gutierrezps/da-pimp-plus/da-pimp-plus-sch.pdf

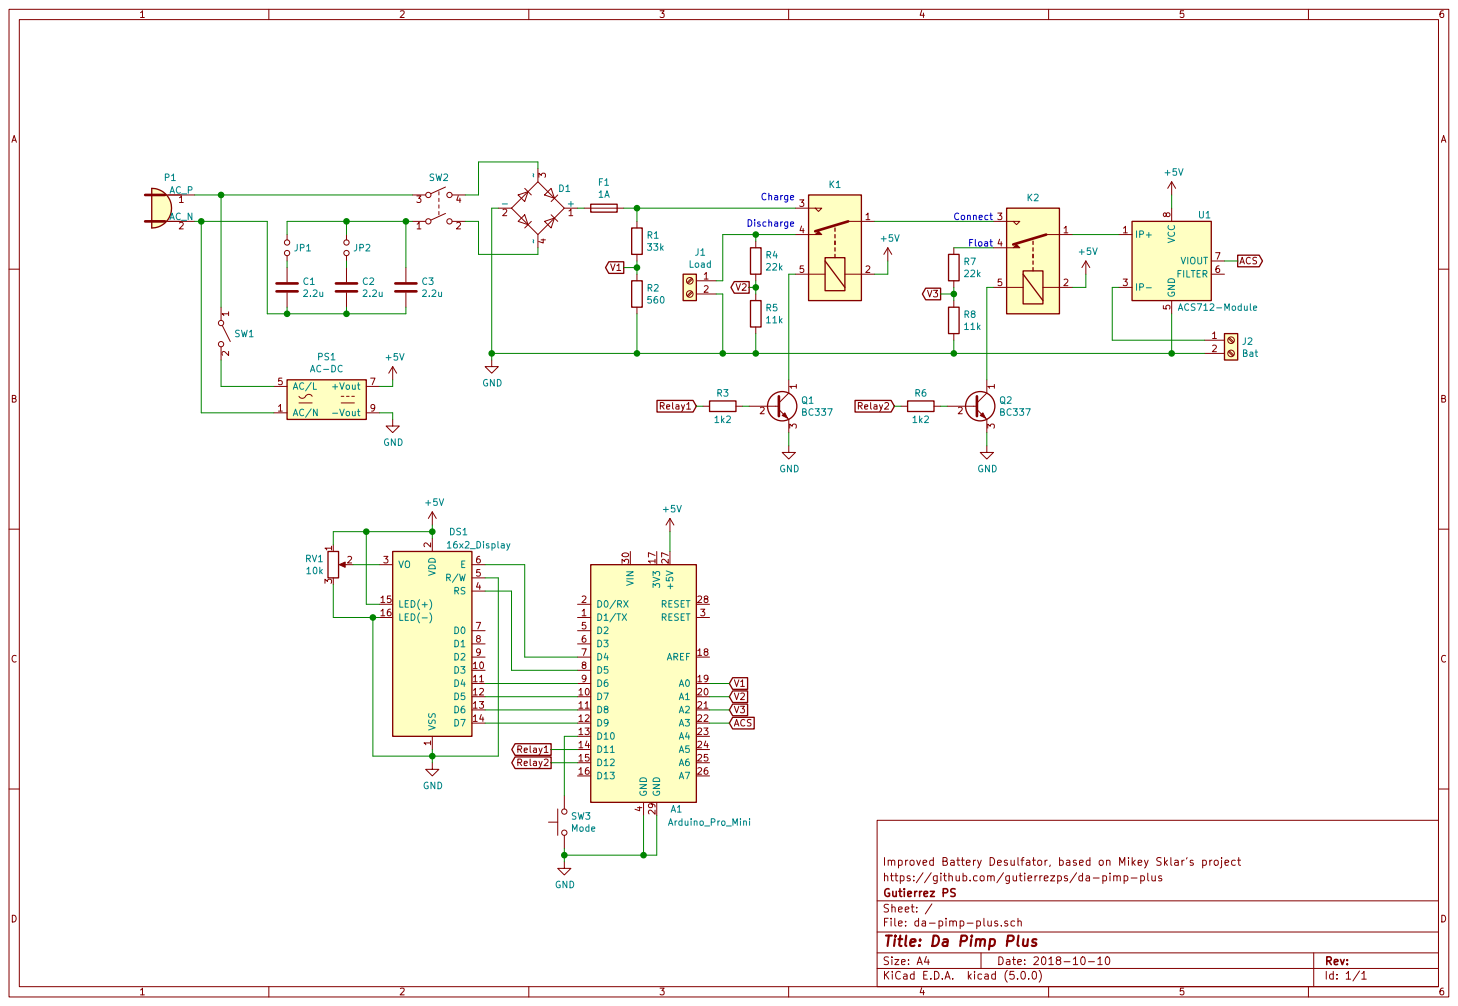
[picture p1: page 1]

Improved Battery Desulfator, based on Mikey Sklar's project
https://github.com/gutierrezps/da-pimp-plus
File: da-pimp-plus.sch Sheet: / Gutierrez PS

Id: 1/1 Title: Da Pimp Plus
