gutierrezps/da-pimp-plus/(commit log)

2018-10-05 Add analog voltage readings and displaying on LCD
2018-10-08 Add mode selection and current offset calibration for each mode
2018-10-08 Increased number of samples and calibration time
2018-10-10 Add mode timer, updated mode factors
2018-10-11 Add KiCad 5 schematic
    [da-pimp-plus.kicad_pcb, da-pimp-plus.sch]
2018-10-11 Added schematic PDF and information on readme
2018-11-07 Added bill of materials
    [bill-of-materials.csv]
